zhaoqiliang2281/Synchronous_Rectification_BUCK/原理图.pdf

# OLED1 DGND MCU_3V³

# 指示灯

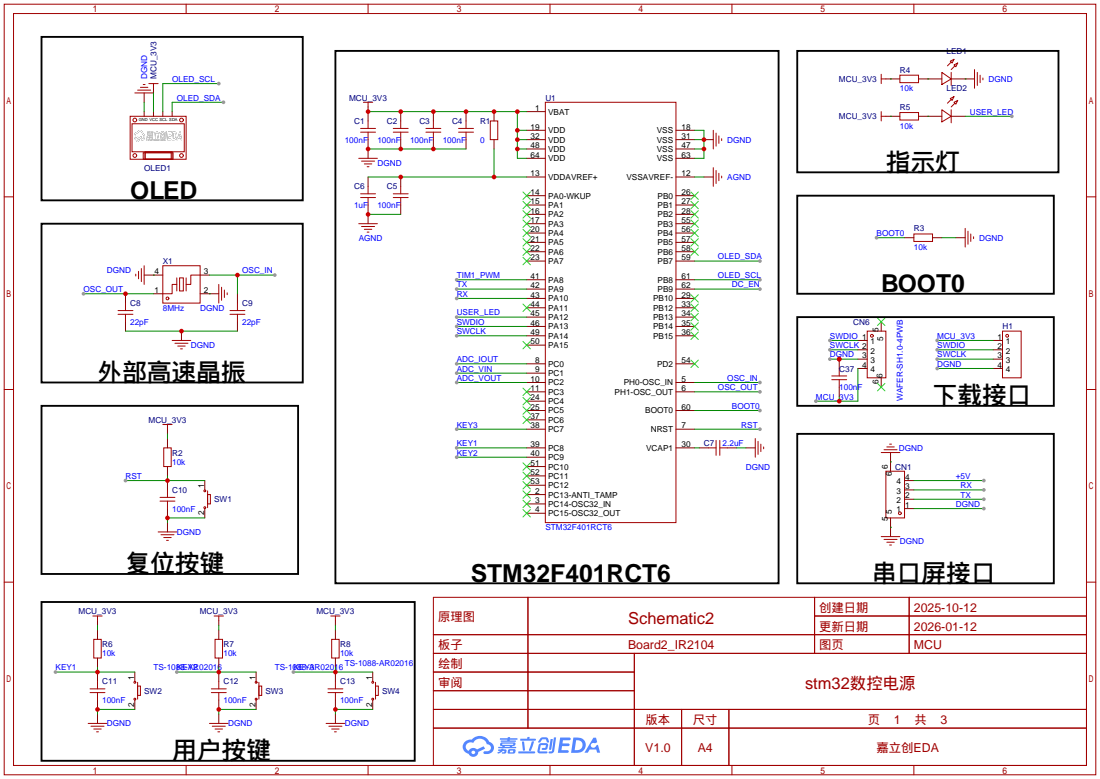
[picture p3: page 1]

GND VCC SCL SDA
OLED

原理图 | Schematic2 | 创建日期 | 2025-10-12

更新日期 | 2026-01-12

板子 | Board2_IR2104 | 图页 | MCU
绘制 | | stm32数控电源
审阅

版本 | 尺寸 | 页 1 共 3
V1.0 | A4 | 嘉立创EDA

GND A1B12 VBUS A4B9 CC1 A5 DP1 A6 DN1 A7 SBU1 A8 CC2 B5 DP2 B6 DN2 B7 SBU2 B8 VBUS B4A9 GND B1A12 SHELL 1

PD诱骗20V输入 | 20-48V输入

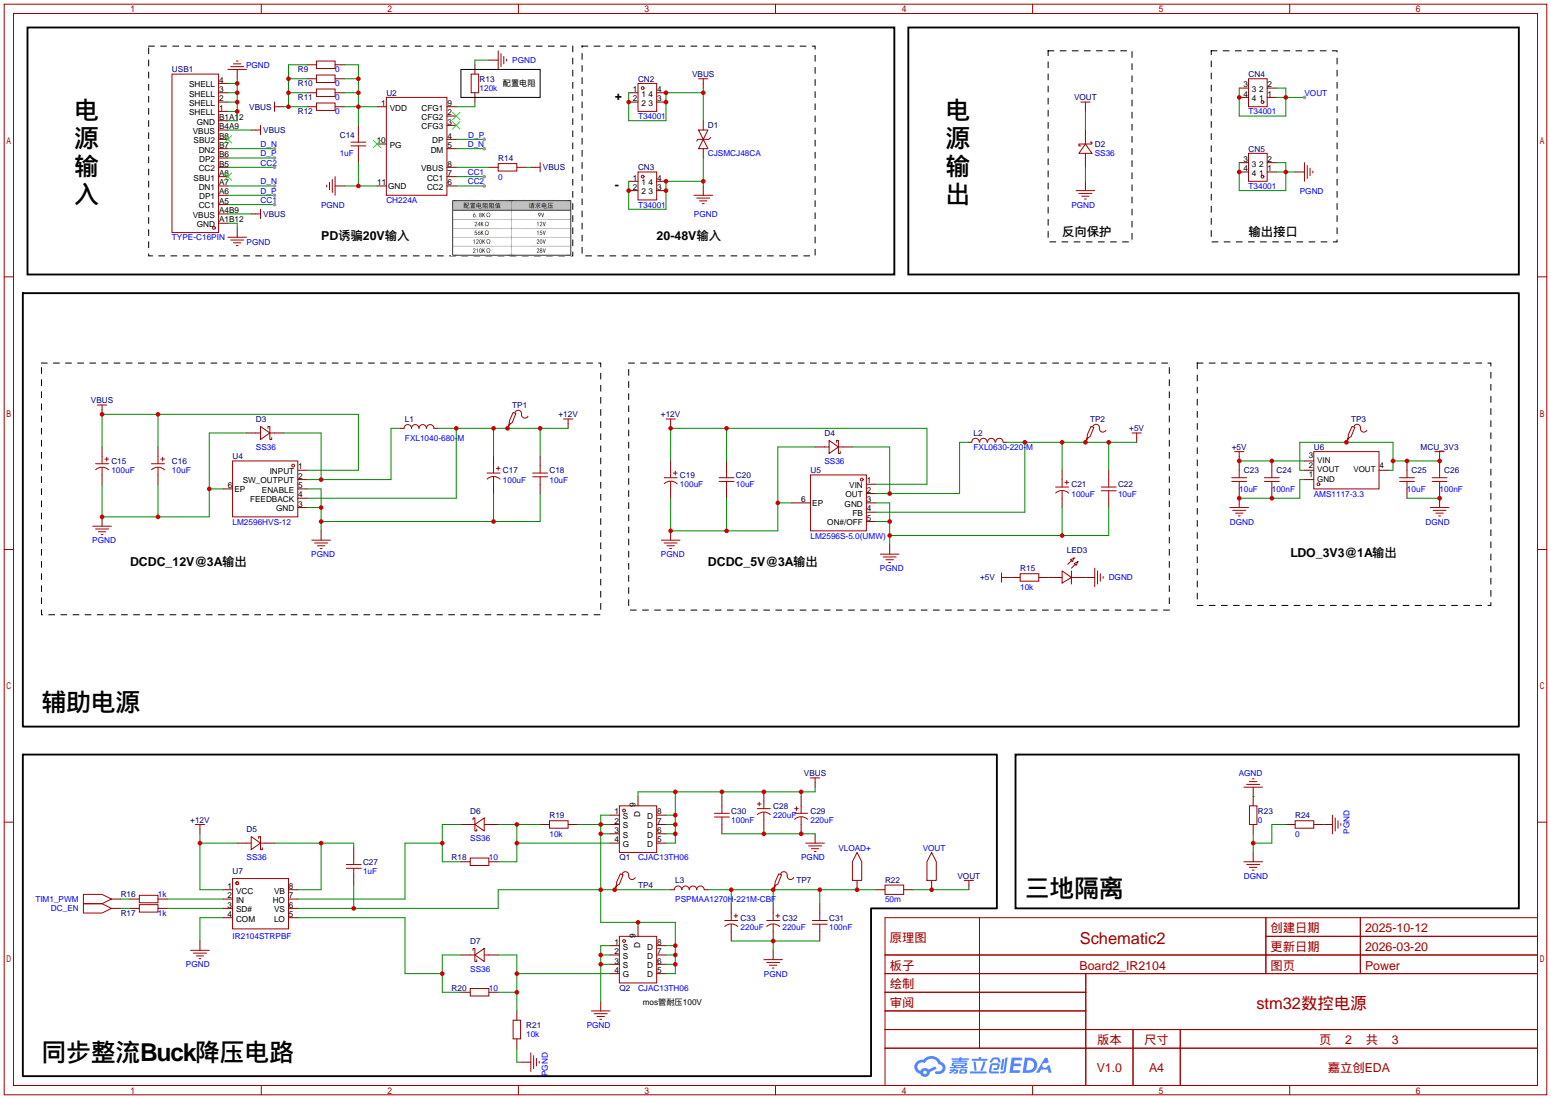
[picture p4: page 2]

原理图 | Schematic2 | 创建日期 | 2025-10-12

更新日期 | 2026-03-20

板子 | Board2_IR2104 | 图页 | Power
绘制 | | stm32数控电源
审阅

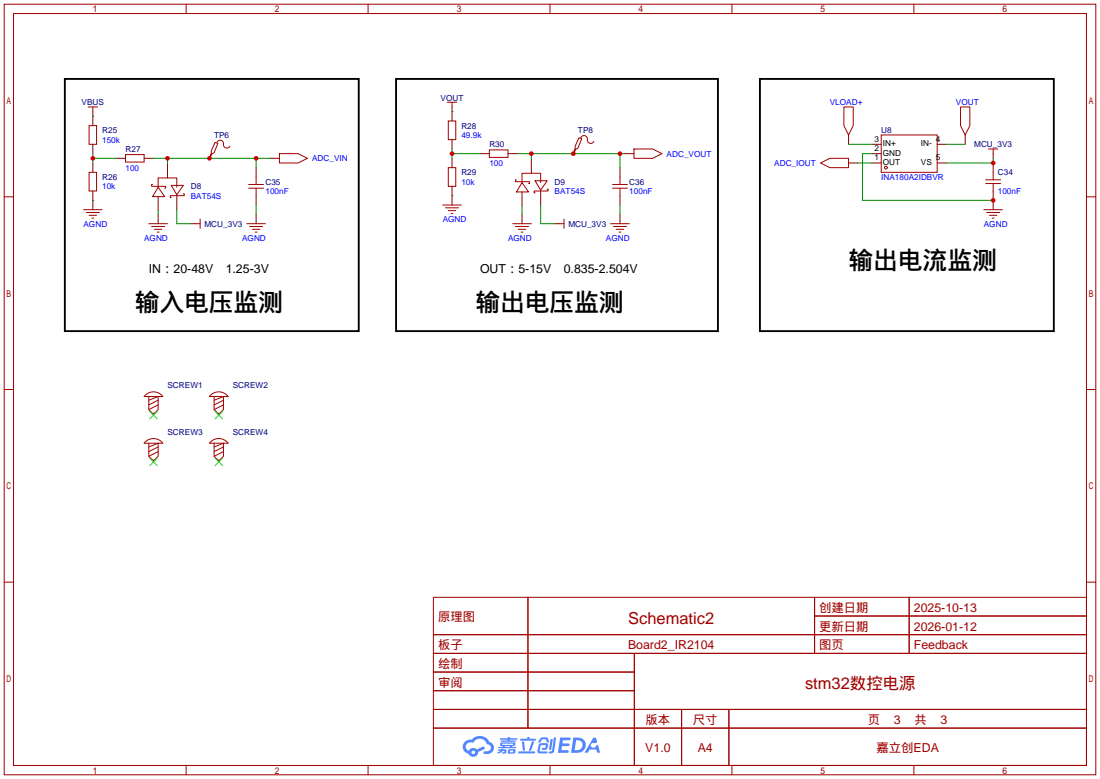
[picture p5: page 3]

原理图 | Schematic2 | 创建日期 | 2025-10-13

更新日期 | 2026-01-12

板子 | Board2_IR2104 | 图页 | Feedback
绘制 | | stm32数控电源
审阅
