zhaoqiliang2281/Synchronous_Rectification_BUCK/Buck_Project/Buck_Project.ioc

Mcu.UserName=STM32F401RCTx
PA10.Signal=USART1_RX
PA12.GPIO_Label=USER_LED
PA12.Signal=GPIO_Output
PA13.Signal=SYS_JTMS-SWDIO
PA14.Signal=SYS_JTCK-SWCLK
PA8.Signal=S_TIM1_CH1
PA9.Signal=USART1_TX
PB7.GPIO_Label=OLED_SDA
PB7.Signal=I2C1_SDA
PB8.GPIO_Label=OLED_SCL
PB8.Signal=I2C1_SCL
PB9.GPIO_Label=DC_EN
PB9.Signal=GPIO_Output
PC0.Signal=ADCx_IN10
PC1.Signal=ADCx_IN11
PC2.Signal=ADCx_IN12
PC7.GPIO_Label=KEY3
PC7.Signal=GPIO_Input
PC8.GPIO_Label=KEY1
PC8.Signal=GPIO_Input
PC9.GPIO_Label=KEY2
PC9.Signal=GPIO_Input
