zhaoqiliang2281/Synchronous_Rectification_BUCK/Buck_Project/Core/Inc/main.h

#define KEY3_Pin GPIO_PIN_7
#define KEY3_GPIO_Port GPIOC
#define KEY1_Pin GPIO_PIN_8
#define KEY1_GPIO_Port GPIOC
#define KEY2_Pin GPIO_PIN_9
#define KEY2_GPIO_Port GPIOC
#define USER_LED_Pin GPIO_PIN_12
#define USER_LED_GPIO_Port GPIOA
#define OLED_SDA_Pin GPIO_PIN_7
#define OLED_SDA_GPIO_Port GPIOB
#define OLED_SCL_Pin GPIO_PIN_8
#define OLED_SCL_GPIO_Port GPIOB
#define DC_EN_Pin GPIO_PIN_9
#define DC_EN_GPIO_Port GPIOB
