zhaoqiliang2281/Synchronous_Rectification_BUCK/(commit log)

2026-11-09 同步整流BUCK 数控电源验证
2026-11-09 增加说明
2026-11-09 修改说明
2026-11-09 增加实物图
2026-11-09 修改说明文件
