zhaoqiliang2281/Synchronous_Rectification_BUCK/(notices)

Notices in the files:
Buck_Project/Core/Src/main.c:
Copyright (c) 2026 STMicroelectronics.
All rights reserved.
This software is licensed under terms that can be found in the LICENSE file
